keycard-tech/keycard-shell/hardware/shell/pilot_run/mechanical/parts/2282-008-WINDOWADHESIVE-V00-20241128.STEP

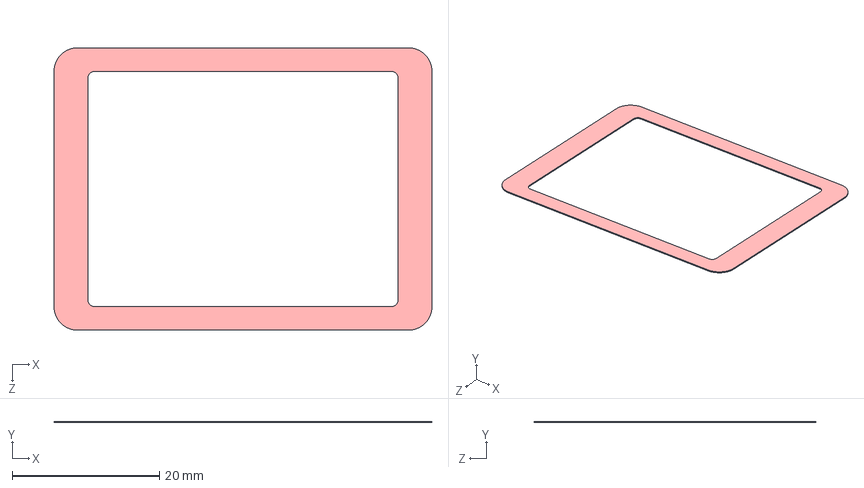
[picture p1: CAD file, 2025-05-23]
hardware/shell/pilot_run/mechanical/parts/2282-008-WINDOWADHESIVE-V00-20241128.STEP
51.4 x 0.2 x 38.4 mm
