keycard-tech/keycard-shell/hardware/shell/pilot_run/mechanical/parts/2282-007-CAMERAWINDOW-V00-20241128.PDF

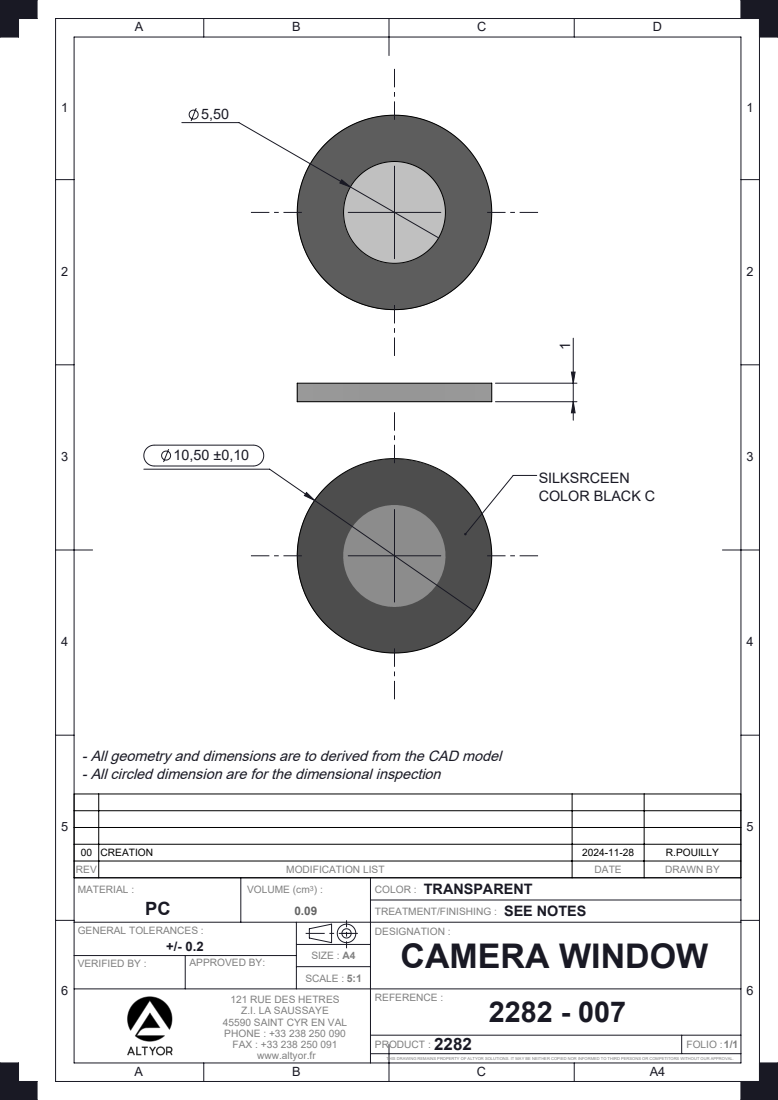
[picture p1: page 1]
COLOR BLACK C; SCALE :; SIZE : A4; MATERIAL :; VOLUME (cm3) :; COLOR :; TREATMENT/FINISHING :; SEE NOTES

- All geometry and dimensions are to derived from the CAD model
- All circled dimension are for the dimensional inspection

00 | CREATION | 2024-11-28 | R.POUILLY
REV | MODIFICATION LIST | DATE | DRAWN BY

GENERAL TOLERANCES : +/- 0.2 | | DESIGNATION : CAMERA WINDOW

VERIFIED BY : | APPROVED BY:

121 RUE DES HETRES Z.I. LA SAUSSAYE 45590 SAINT CYR EN VAL PHONE : +33 238 250 090 FAX : +33 238 250 091 www.altyor.fr | REFERENCE : 2282 - 007

PRODUCT : | FOLIO : 1/1

THIS DRAWING REMAINS PROPERTY OF ALTYOR SOLUTIONS. IT MAY BE NEITHER COPIED NOR INFORMED TO THIRD PERSONS OR COMPETITORS WITHOUT OUR APPROVAL.
